clabar01/me193-step-counter/docs/figures/bench_01_us_gyro.png

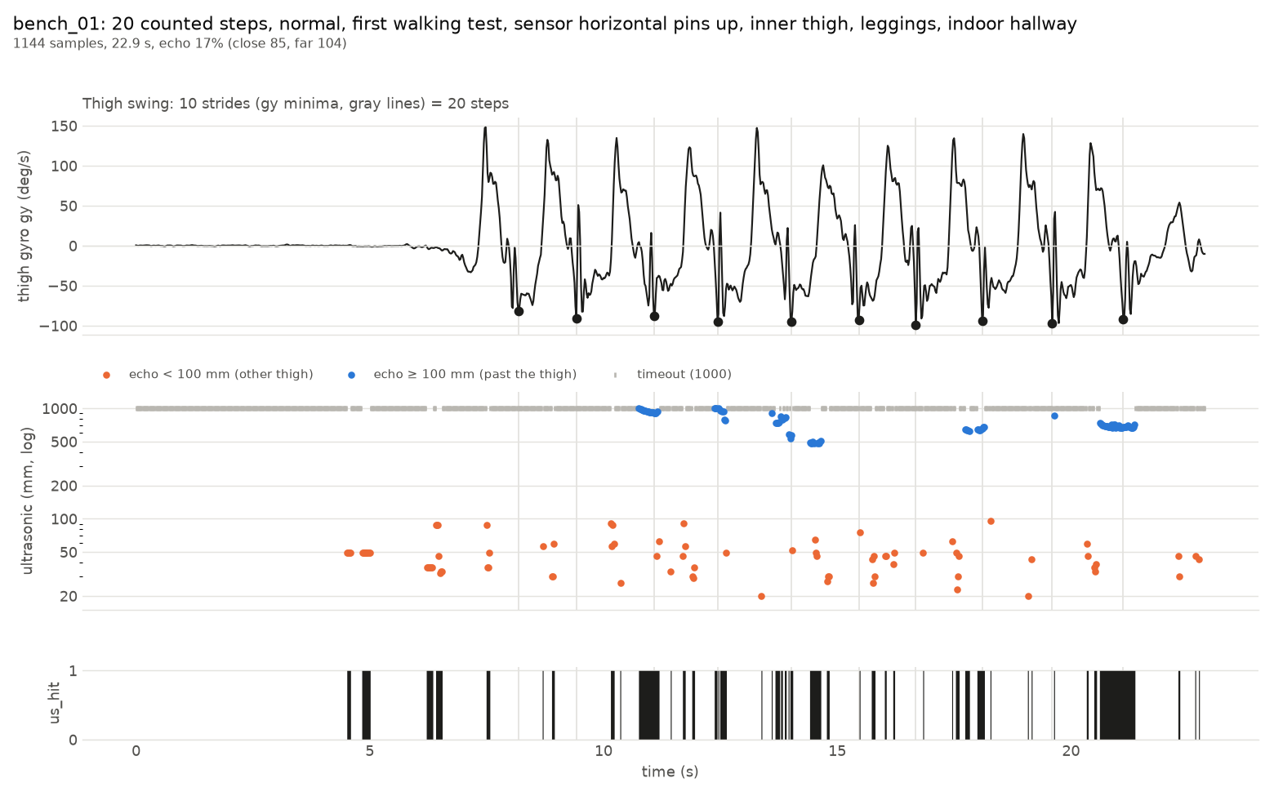
docs/figures/bench_01_us_gyro.png
