clabar01/me193-step-counter/docs/figures/step_detector/real/loss_curves.png

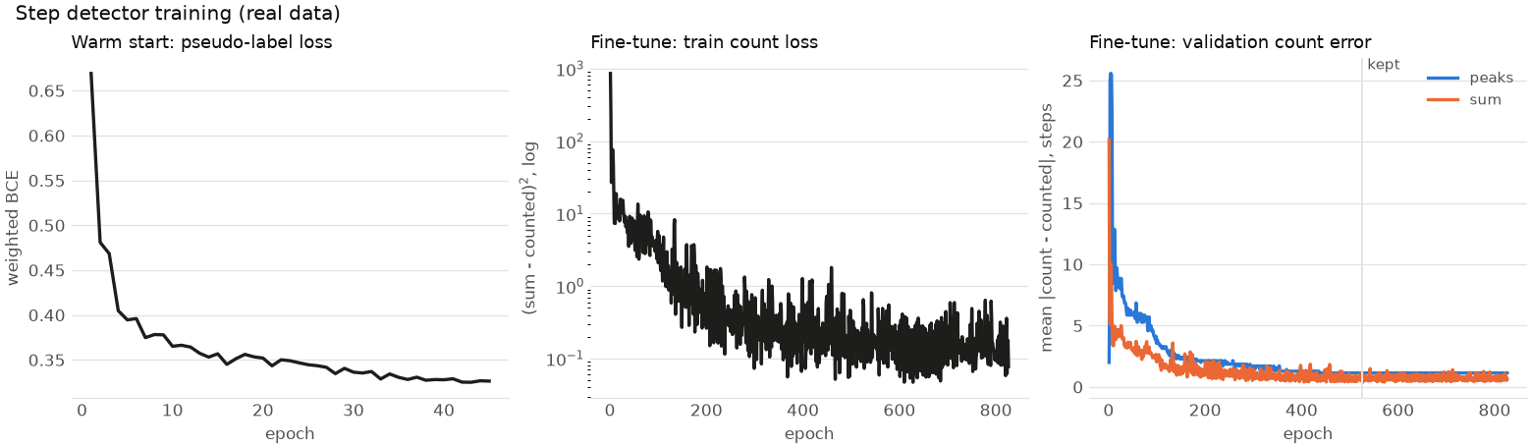
docs/figures/step_detector/real/loss_curves.png
