clabar01/me193-step-counter/models/step_length/real/results.csv

trial | speed | distance_m | counted | steps | fixed | weinberg | pendulum | mlp | fixed_err% | weinberg_err% | pendulum_err% | mlp_err%
B_01 | normal | 19.0 | 24 | 24 | 18.833 | 18.784 | 19.456 | 18.652 | -0.881 | -1.138 | 2.403 | -1.831
B_02 | normal | 19.0 | 24 | 24 | 18.833 | 19.1 | 18.786 | 18.405 | -0.881 | 0.528 | -1.125 | -3.131
B_03 | normal | 30.0 | 37 | 38 | 29.83 | 29.819 | 30.245 | 30.245 | -0.567 | -0.604 | 0.816 | 0.816
B_04 | normal | 19.0 | 25 | 26 | 20.666 | 19.842 | 19.043 | 20.021 | 8.771 | 4.431 | 0.228 | 5.371
B_05 | slow | 19.0 | 25 | 25 | 19.738 | 19.048 | 19.622 | 18.725 | 3.884 | 0.255 | 3.275 | -1.445
B_06 | slow | 30.0 | 41 | 42 | 33.53 | 31.312 | 32.598 | 30.596 | 11.767 | 4.372 | 8.662 | 1.988
B_07 | fast | 19.0 | 23 | 22 | 17.083 | 18.399 | 17.534 | 18.7 | -10.091 | -3.161 | -7.717 | -1.577
B_08 | fast | 11.0 | 12 | 12 | 9.267 | 10.432 | 10.131 | 11.309 | -15.758 | -5.166 | -7.898 | 2.812
