clabar01/me193-step-counter/docs/figures/step_detector/real/validation_trials.png

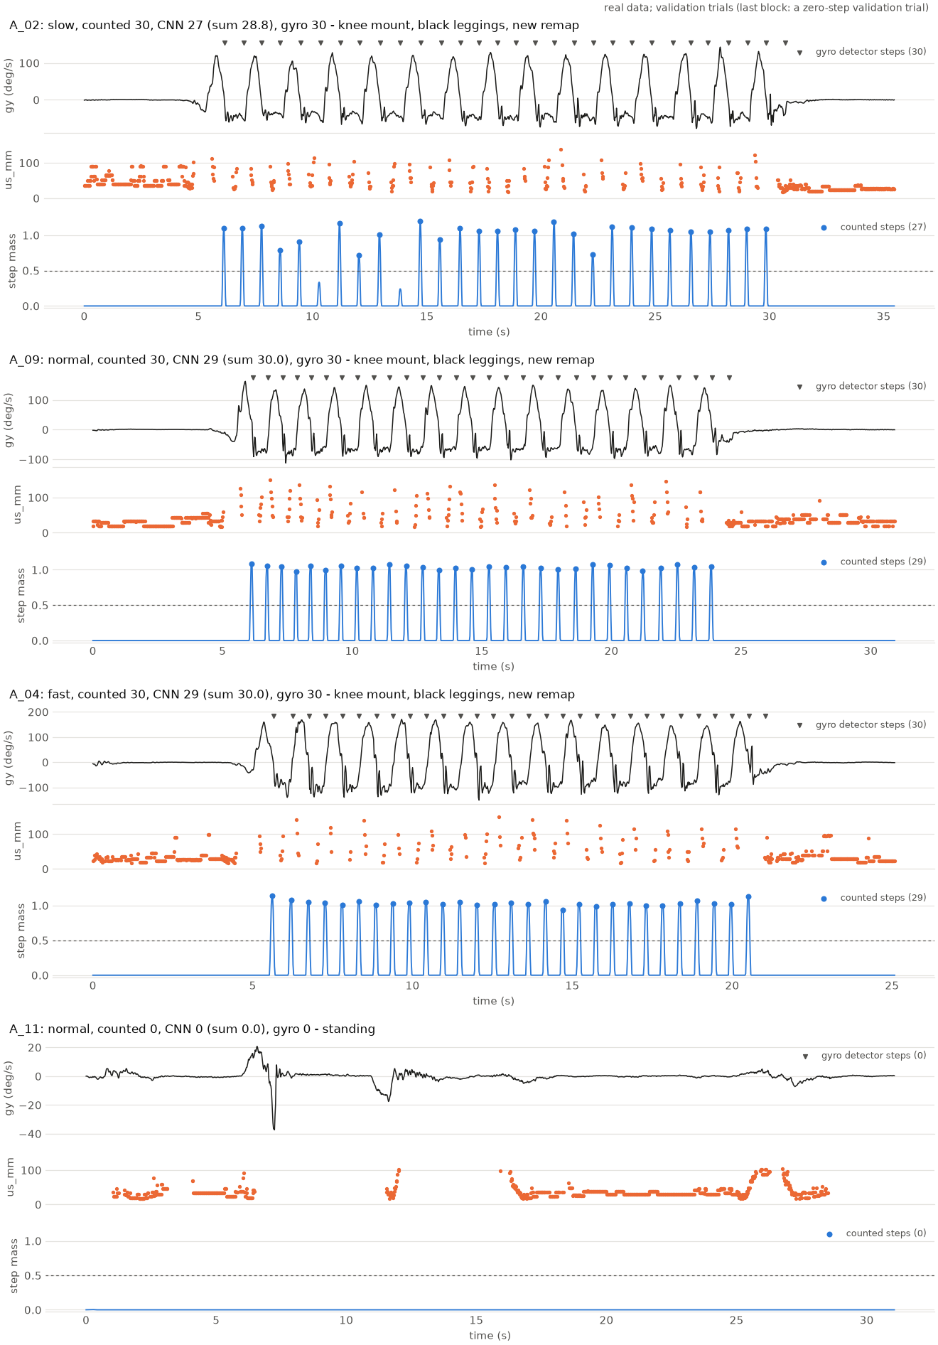
docs/figures/step_detector/real/validation_trials.png
