clabar01/me193-step-counter/docs/figures/step_detector/sim/test_trials.png

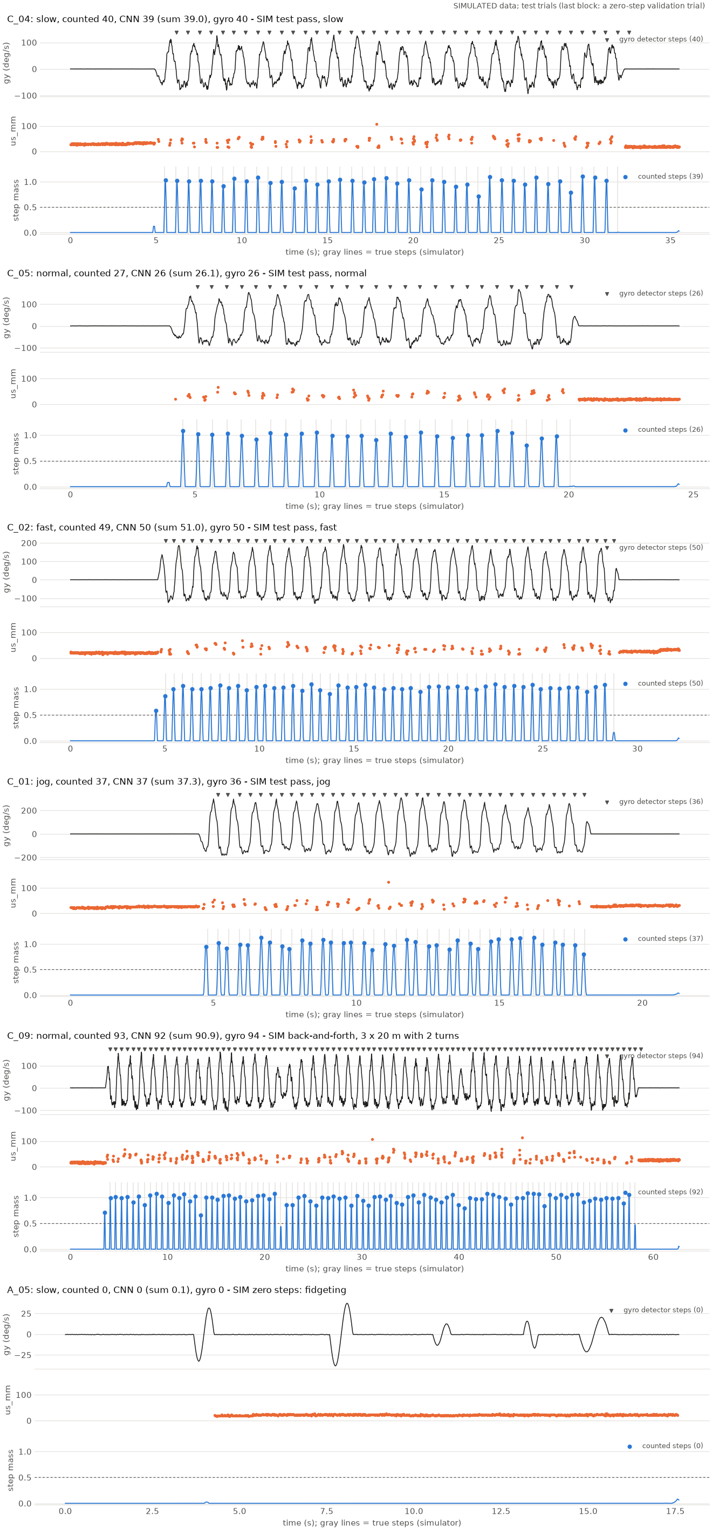
docs/figures/step_detector/sim/test_trials.png
