clabar01/me193-step-counter/(commit log)

2026-10-28 Import base code from me193-gait
    Imported from me193-gait at commit 1ce311c94ac2c4e84cfc80f86d7e4e747a3fc9da
    (https://github.com/clabar01/me193-gait), reorganized into board/, training/,
    analysis/, dashboard/ and animation/. The board app is renamed me193_steps and
    MQTT topics moved to ME193/ceci/steps/ so it doesn't clash with me193_gait.
    Recorded data, trained models, gait-specific model scripts, figures and the
    Notion draft were not copied. requirements.txt adds torch.
    [i2c_scanner.ino]
2026-10-28 README: HC-SR04 between the thighs instead of ToF + FSRs
    The sensor plan changed: one HC-SR04 ultrasonic (from me193-sumo) on the
    thigh strap pointing at the other thigh, and step labels come from hand-counted
    trials, not foot sensors. Adds the HC-SR04 wiring with the Echo voltage divider.
2026-10-28 Phase 2: trial logging with HC-SR04, Trial page, simulator
    Board: the sketch pings the HC-SR04 once per 50 Hz IMU sample with a
    non-blocking, interrupt-timed driver (6 ms / 1 m cutoff, timeouts logged as
    us_mm=1000, us_hit=0) and draws recording-state icons. The Python side
    records trials to <session>_<trial>.csv + .json on dashboard commands over
    MQTT (recorder.py) and publishes a retained trial state. The gait live
    classifier is removed.
    Laptop: dashboard/trial.html (phone-friendly Trial panel with live ultrasonic
    and gyro plots), serve.py --lan (serves only dashboard/ and animation/),
    board/pull_recordings.py, plot_raw.py for the new format, and a simulator with
    known step counts per spe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
2026-11-02 Add gyro vs ultrasonic plot and bench_01 figure
    plot_us_gyro.py plots thigh gyro gy (stride minima marked), HC-SR04 distance
    and echo/timeout for one trial on a shared time axis. bench_01 (first 20-step
    walking test) shows 10 gy strides = 20 steps, but no reliable ultrasonic dip
    every step. Figures now go in docs/figures/.
2026-11-03 Final low mount: compare bench_01/04, measured IMU axis remap
    plot_us_gyro.py now marks strides at the thigh swing peaks (one per stride
    period from the gy autocorrelation) instead of the gy minima, which split and
    caught the first/last half-steps with the IMU lower on the thigh (bench_04
    read 24 steps for 20). Close echo bursts are matched to this leg's swing or
    the other leg's half a stride later, and standing is reported before and
    after walking separately.
    bench_04 (HC-SR04 just above the knee) vs bench_01: thigh passes seen 19/19
    vs 16/19, no stray bursts vs 1, bursts 80 ms vs 40 ms median.
    The sketch now applies a measured rotation BODY_R instead of an axis swap:
    x from gravity while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
    [sketch.ino]
2026-11-03 Add bench_04 vs A_01 figure, note ultrasonic clipping for training
    A_01, the first Session A trial with the measured axis remap: standing reads
    (0.946, 0.035, -0.036) g, 15 strides = 30 counted steps, close echo bursts on
    15/15 and 14/14 thigh passes, no stray bursts.
    The README now says to clip us_mm at about 150 mm before making features, since
    farther echoes come from walls and furniture, and to skip bench_* trials.
2026-11-03 CNN step detector pipeline, knee-mount simulator and fake dataset
    Simulator (training/simulator.py) rebuilt for the knee mount and BODY_R frame:
    walking plays back the average real stride fitted from bench_04 and A_01
    (scripts/fit_sim_template.py -> training/sim_template.json), with heel-strike
    scatter, close ultrasonic bursts at both thigh passes, steady 17-30 mm or no
    echo when standing, wall clutter, strap offsets, fidgeting, sitting down and
    turns. Speeds are slow/normal/fast/jog only.
    scripts/make_sim_dataset.py writes FAKE sessions A/B/C to data/sim/raw in the
    board's recorder format, with occasional +-1 miscounts, and true step times to
    data/sim/truth for evaluation only.
    training/s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
    [results.csv]
2026-11-03 Step detector: first real-data results, training length in updates
    First run on real trials (A_01-A_13, B_01-B_08; bench_* skipped), with a
    whole-trial validation split while there is no session C. On 7 validation
    trials, mean count error per trial: gyro detector 0.29, CNN sum 0.38, CNN
    peaks 1.14 (peaks usually miss a weak first or last step).
    train.py: training length is set in optimizer updates instead of epochs,
    since 14 real trials are only 2 batches per epoch and the epoch counts tuned
    on the simulator stopped too early. New --train-sessions option. Per-trial
    plots use validation trials when there is no test set; shorter axis labels.
    The simulated results were regenerated with the new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
    [results.csv]
2026-11-03 Phase 5: step-length MLP and baselines on Session B distance trials
    training/step_length/: each distance trial (its own tape-measured distance in
    the json) is split into steps by the gyro stride detector, main walking bout
    only, and each step gets step time, thigh swing angle (drift-removed gy
    integral over the stride), accel magnitude range, closest ultrasonic reading
    and burst length (same preprocessing as the step detector: BODY_R, us_mm
    clipped at 150 mm, bench_* skipped, --data-dir).
    The MLP (5 -> 16 -> 16 -> 1, ReLU, softplus, z-scored with training stats,
    385 weights, Adam + weight decay) is trained only on the per-trial loss
    ((sum of step lengths - distance) / distance)^2. It is com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
    [results.csv]
2026-11-03 Track the final real-data model weights
    .gitignore exceptions for models/step_detector/real/model.pt (74 KB) and
    models/step_length/real/model.pt (4 KB), so the board and grading can use
    them. Other checkpoints stay ignored.
2026-11-03 Phase 6: both models live on the board, new step-counter dashboard
    Board: scripts/export_models.py turns the real-data step detector and
    step-length MLP into numpy .npz files (models/ and board/python/models/).
    board/python/live_steps.py runs them with numpy only: every 0.25 s the CNN runs
    on the last 6 s; a sample is finalized once the CNN has its full +-1.2 s of
    context, and each sample is decided once, so steps are never counted twice
    across windows. Each step's length (its features + the MLP) is computed when
    the next step arrives. main.py publishes <prefix>/live every 0.25 s (steps,
    distance, cadence, step length, step-detector output, new steps), <prefix>/step
    per step, and takes {"cmd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
2026-11-03 Trial page waits for slow board replies; latency tool uses the board clock
    trial.html: with the public broker taking 2-5 s each way, the 6 s reply
    timeout unlocked the buttons early, and repeated presses then reached the
    board late and in a burst (start, start, stop, discard, start). It now says
    "still waiting" after 6 s and only unlocks after 30 s; a late reply is still
    matched to its command.
    measure_latency.py: the count delay was estimated from raw-data arrival times,
    which are delayed by the same network (it reported a 4 ms minimum). It now
    reports the detection lag on the board's sample clock, the network delay from
    the live message's publish time (board clock is NTP-synced), and thei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
2026-11-03 Document the turning limitation with bench_05
    bench_05 (small room with turns, 20 steps counted): gyro detector 22, CNN 10,
    offline and live on the board alike. The training data is straight hallway
    walking only; turning twists the thigh about its long axis and breaks up the
    forward-swing pattern the CNN learned. Figure and numbers in
    docs/step_detector.md section 8; the recording stays local in data/raw/.
2026-11-03 Explainer animation: 7 scenes in plain JS from real training snapshots
    animation/explainer.html draws a 2:50 explainer on a 1920x1080 canvas (dark
    background, one colour per sensor), with play/pause, scene navigation and a
    "play all for recording" mode that hides the controls: hardware, the 8 input
    channels, the forward pass with the real feature maps, the warm start and the
    count loss, backprop (layer gradients, weights, loss curve, predictions
    improving), the step-length MLP against the tape-measured hallway, and the
    live system. Manim was dropped: pycairo can't be built on this Mac.
    animation/record_training.py re-runs the real step-detector training (same
    seed; checked identical to the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
2026-11-03 Uncertainty analysis: analysis/evaluate.py -> analysis/results.md
    Step count per test trial (CNN and gyro detector): mean absolute error, SD,
    bias and 95% bootstrap CIs by speed, with a predicted-vs-counted scatter.
    Distance error for the MLP, fixed step, Weinberg and pendulum (leave-one-
    trial-out over the A/B distance trials), plus end-to-end on the CNN's steps
    as on the board. Ablation of the ultrasonic, each variant retrained exactly
    like the committed model with 3 seeds (seed 0 reproduces it): step detector
    IMU+US 0.81 vs IMU-only 0.38 steps per trial on the stand-in set, so it does
    not clearly help counting; step-length MLP 2.4% vs 3.8% without the
    ultrasonic features, higher in every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
2026-11-03 CNN counting rule: peaks + gyro-checked edge steps, chosen on training trials
    The peaks-only count missed ~1 step per walk, nearly always the last one,
    where the CNN output is ~0 rather than a weak peak. analysis/counting_rule.py
    compares a lower threshold, round(sum) and edge-step rules by retraining the
    CNN in 7 folds x 2 seeds inside the 14 training trials and scoring held-out
    ones (validation and Session C unused). The board-ready gyro-checked edge
    rule wins (0.96 vs 1.50 steps/trial; round(sum) 4.29), frozen as
    counting.count_steps and ported to live_steps.py with a numpy copy of the
    gyro stride detector. Validation: CNN 1.14 -> 0.29 steps/trial; board-path
    distance 4.0% -> 3.0%. Weight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
2026-11-03 Session C test results; fix two report wordings
    analysis/results.md now holds the held-out Session C test (6 trials, 173
    steps, 23 m each): gyro detector 1.17 steps/trial off, CNN 3.00 (old rule
    6.83); distance pendulum 3.2%, Weinberg 4.2%, fixed 4.9%, MLP 17.3%,
    board path 11.8%. The ultrasonic echoes were much weaker in Session C and
    the IMU-only MLP did clearly better (6.1% vs 17.1%).
    evaluate.py: the step-length ablation verdict now says when the ultrasonic
    features clearly hurt (paired interval below 0), and the last limitation
    is titled for the held-out test set under --test C.
